DMPRO2021-Audio/pcb/readme.md

# PCB for synth project thingy

## [Bill of materials (google sheets)](https://docs.google.com/spreadsheets/d/1mw8S-eOHjplATXsi4Le0auCMZ8W1ZmBKjRO5l_0JOso/edit#gid=0)
