DMPRO2021-Audio/pcb/main/main.kicad_pcb

## KiCad design main/main.kicad_pcb (2021-09-30)

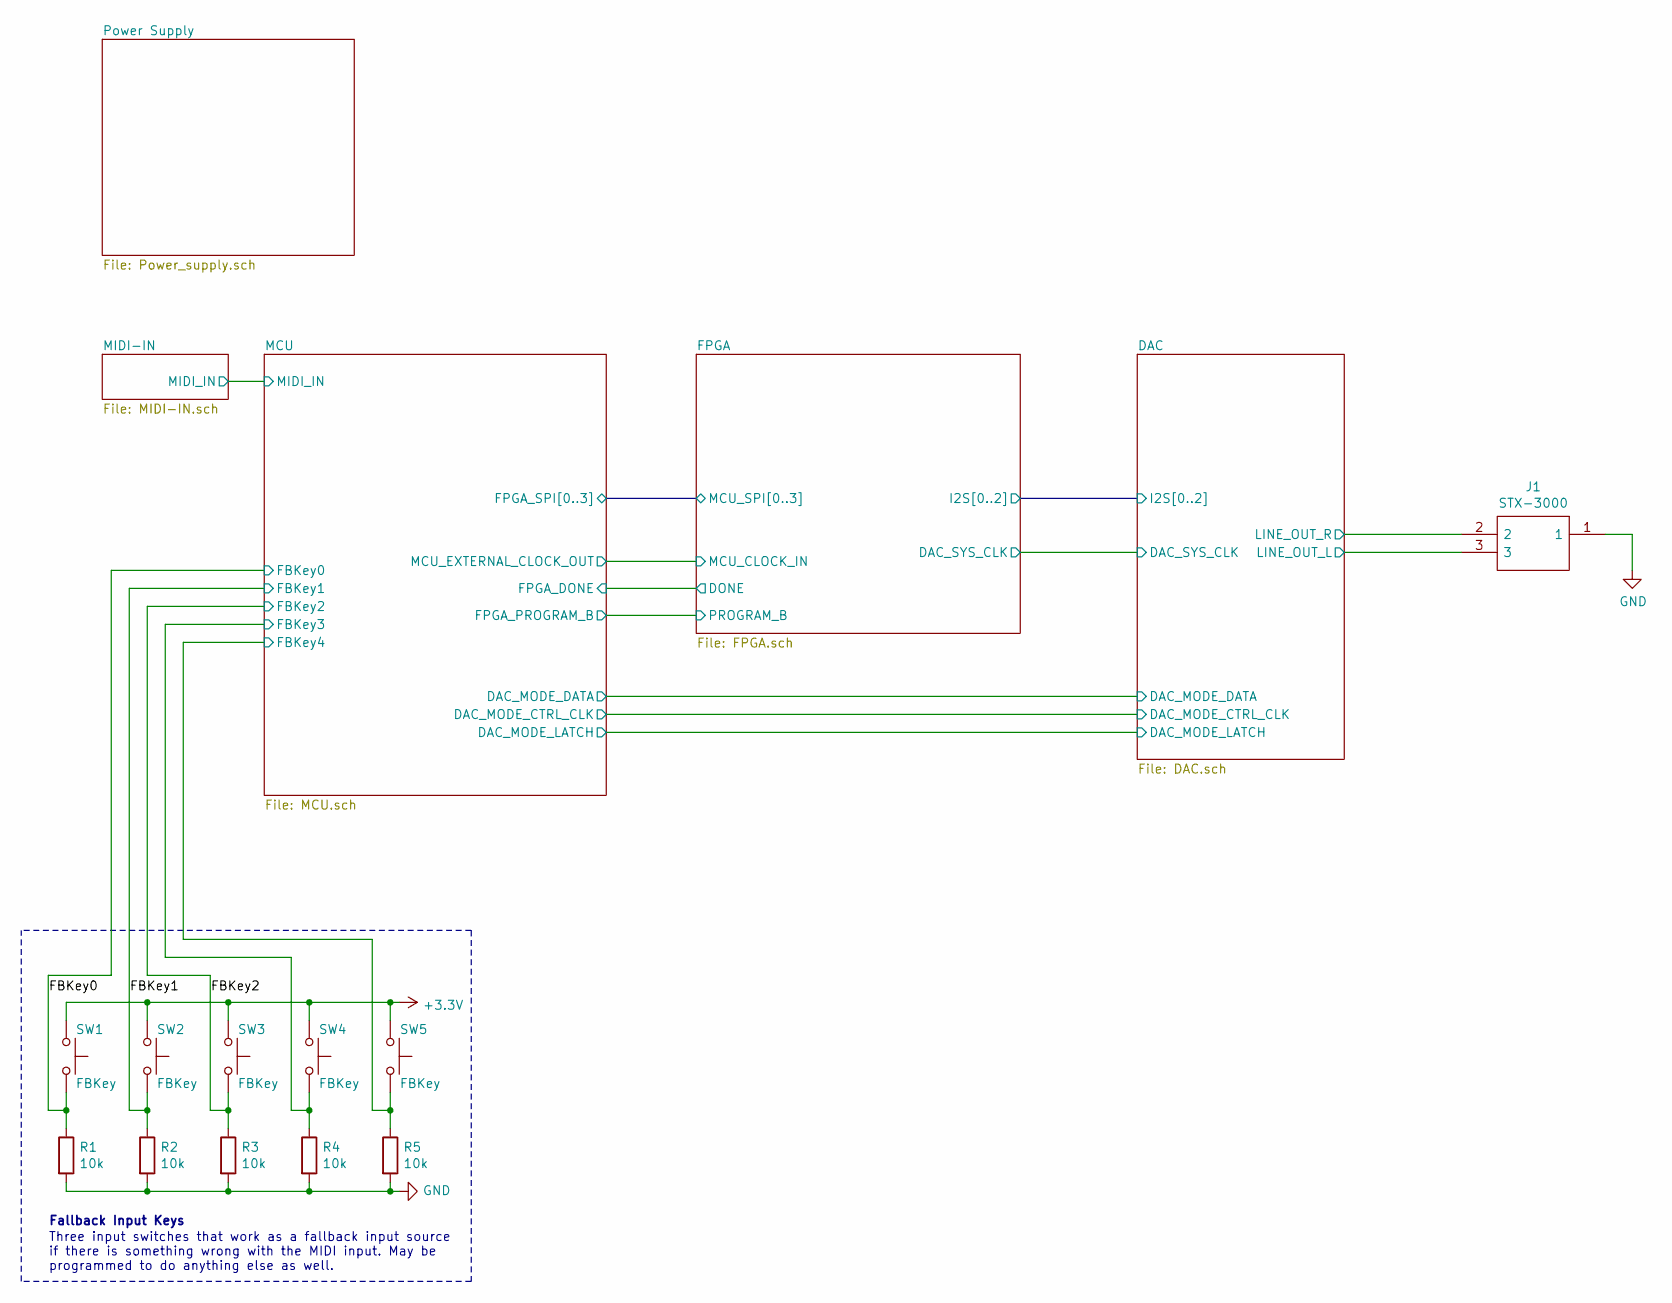
[picture p1: schematic main.sch, MIDI Audio Box]

Parts:
J1: STX-3000; STX3000; Manufacturer_Part_Number STX-3000
R1, R2, R3, R4, R5: 10k; R_0805_2012Metric_Pad1.20x1.40mm_HandSolder
SW1, SW2, SW3, SW4, SW5: FBKey; SW_Push_1P1T_NO_6x6mm_H9.5mm; Manufacturer_Part_Number PTS645SM43SMTR92 LFS

Connections:
+3V3: SW1.1, SW2.1, SW3.1, SW4.1, SW5.1; also elsewhere on the board
/DAC/LINE_OUT_L: J1.3; also elsewhere on the board
/DAC/LINE_OUT_R: J1.2; also elsewhere on the board
/FBKey0: R1.1, SW1.2; also elsewhere on the board
/FBKey1: R2.1, SW2.2; also elsewhere on the board
/FBKey2: R3.1, SW3.2; also elsewhere on the board
/MCU/FBKey3: R4.1, SW4.2; also elsewhere on the board
/MCU/FBKey4: R5.1, SW5.2; also elsewhere on the board
GND: J1.1, R1.2, R2.2, R3.2, R4.2, R5.2; also elsewhere on the board

Notes on the sheet:
Fallback Input Keys
Three input switches that work as a fallback input source if there is something wrong with the MIDI input. May be programmed to do anything else as well.

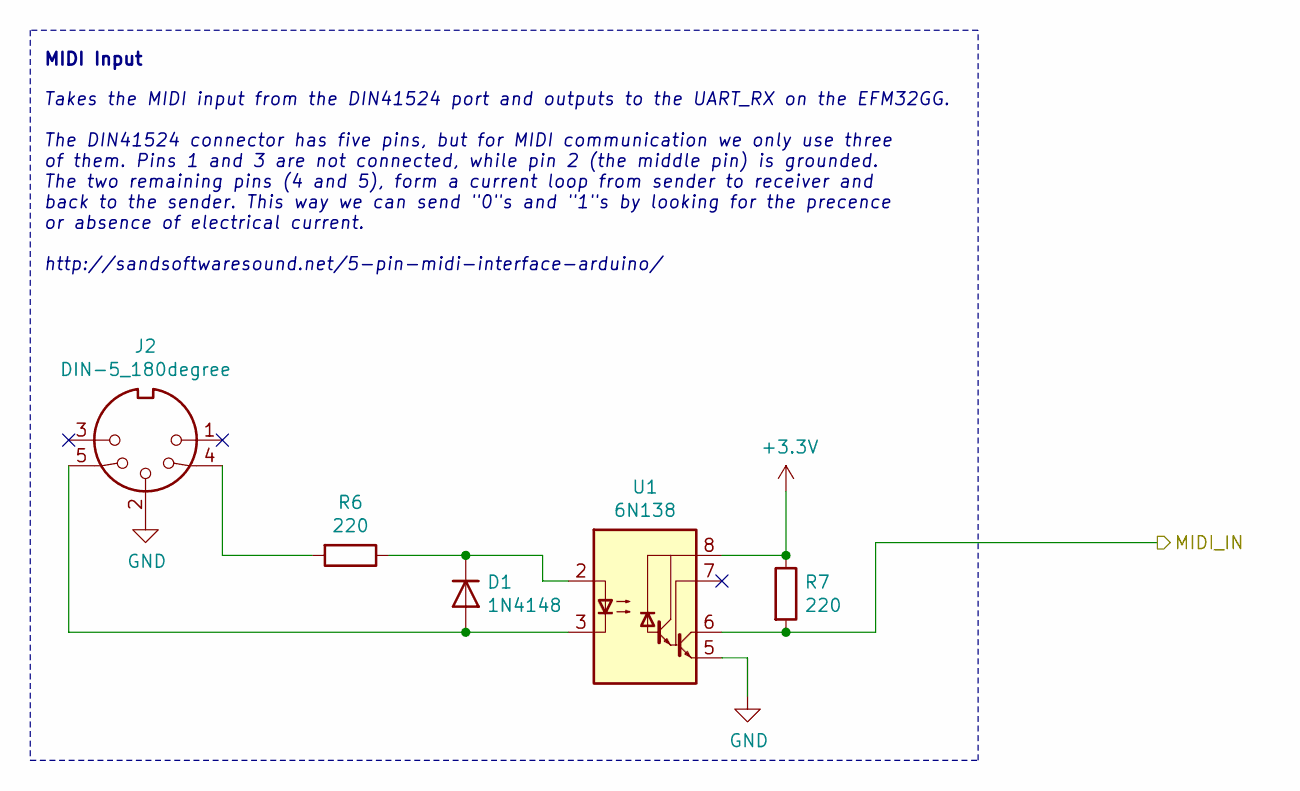
[picture p2: schematic MIDI-IN.sch, MIDI Audio Box]

Parts:
D1: 1N4148; D_SOD-123F; Manufacturer_Part_Number 1N4148W RH
J2: DIN-5_180degree; 671-0501; Manufacturer_Part_Number 671-0501
R6, R7: 220; R_0805_2012Metric_Pad1.20x1.40mm_HandSolder
U1: 6N138; SOP254P1030X460-8N; Manufacturer_Part_Number 6N138SMT/R

Connections:
+3V3: R7.1, U1.8 (VCC); also elsewhere on the board
/MCU/MIDI_IN: R7.2, U1.6 (VO2); also elsewhere on the board
GND: J2.2, U1.5 (GND); also elsewhere on the board
unnamed: D1.1 (K), R6.1, U1.2 (C1)
unnamed: D1.2 (A), J2.5, U1.3 (C2)
unnamed: J2.4, R6.2

Notes on the sheet:
MIDI Input
Takes the MIDI input from the DIN41524 port and outputs to the UART_RX on the EFM32GG. The DIN41524 connector has five pins, but for MIDI communication we only use three of them. Pins 1 and 3 are not connected, while pin 2 (the middle pin) is grounded. The two remaining pins (4 and 5), form a curre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

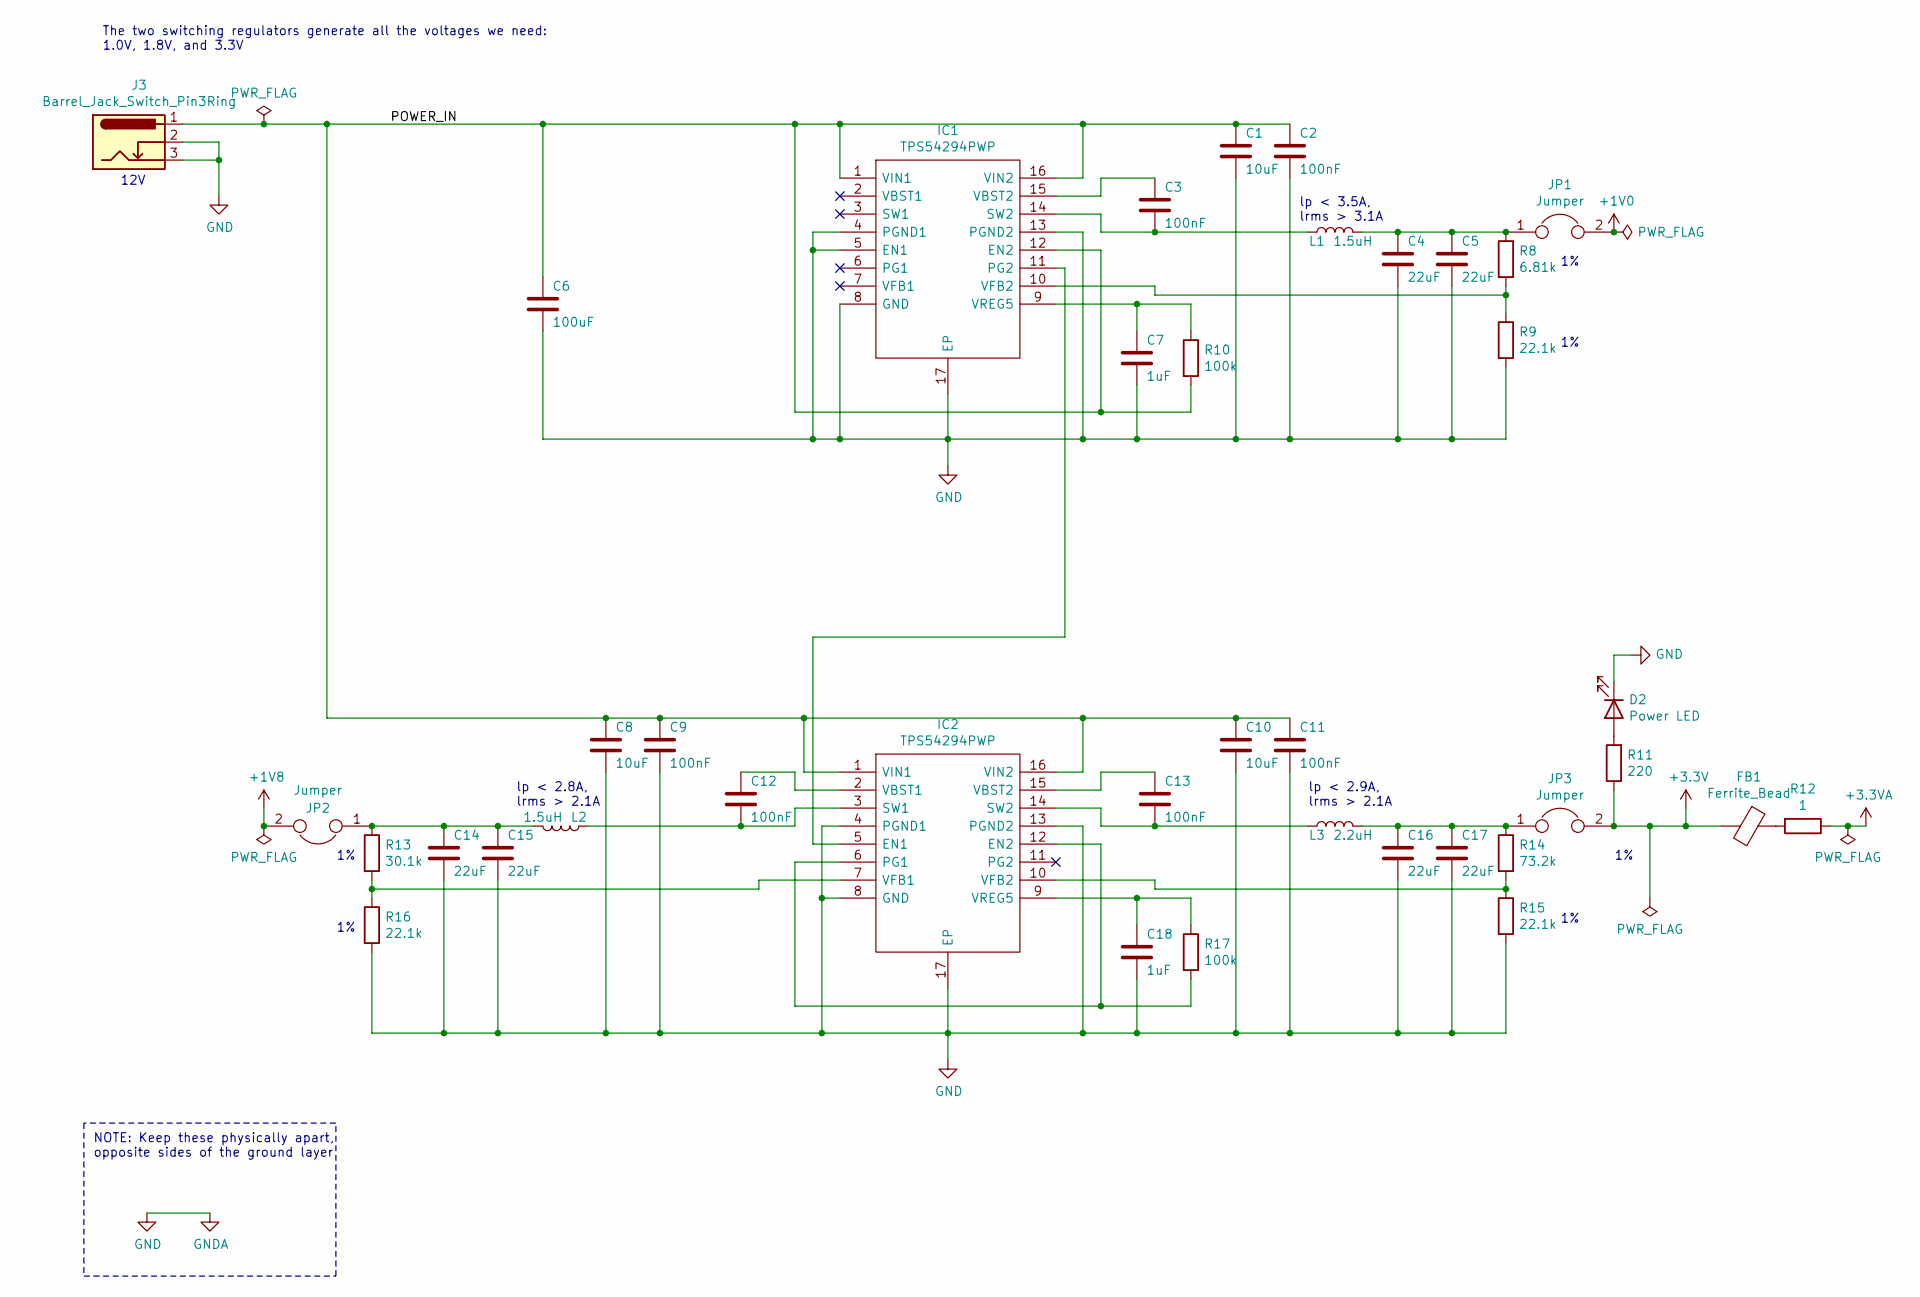
[picture p3: schematic Power_supply.sch, MIDI Audio Box]

Parts:
C1, C8, C10: 10uF; C_0805_2012Metric_Pad1.18x1.45mm_HandSolder
C2, C3, C9, C11, C12, C13: 100nF; C_0805_2012Metric_Pad1.18x1.45mm_HandSolder
C4, C5, C14, C15, C16, C17: 22uF; C_0805_2012Metric_Pad1.18x1.45mm_HandSolder
C6: 100uF; C_1210_3225Metric_Pad1.33x2.70mm_HandSolder
C7, C18: 1uF; C_0805_2012Metric_Pad1.18x1.45mm_HandSolder
D2: Power LED; LED_0805_2012Metric_Pad1.15x1.40mm_HandSolder; Manufacturer_Part_Number 150080RS75000
FB1: Ferrite_Bead; R_0805_2012Metric_Pad1.20x1.40mm_HandSolder; Manufacturer_Part_Number BMB2A0060LN2
IC1, IC2: TPS54294PWP; Manufacturer_Part_Number TPS54294PWP; Mouser Part Number 595-TPS54294PWP
J3: Barrel_Jack_Switch_Pin3Ring; BarrelJack_CUI_PJ-102AH_Horizontal; Manufacturer_Part_Number PJ-002A
JP1, JP2, JP3: Jumper; PinHeader_2x01_P2.54mm_Vertical
L1, L2: 1.5uH; L_1806_4516Metric_Pad1.57x1.80mm_HandSolder; Manufacturer_Part_Number 1286AS-H-2R2M=P2
L3: 2.2uH; L_1806_4516Metric_Pad1.57x1.80mm_HandSolder; Manufacturer_Part_Number DFE201610E-1R5M=P2
R8: 6.81k; R_0805_2012Metric_Pad1.20x1.40mm_HandSolder
R9, R15, R16: 22.1k; R_0805_2012Metric_Pad1.20x1.40mm_HandSolder
R10, R17: 100k; R_0805_2012Metric_Pad1.20x1.40mm_HandSolder
R11: 220; R_0805_2012Metric_Pad1.20x1.40mm_HandSolder
R12: 1; R_0805_2012Metric_Pad1.20x1.40mm_HandSolder
R13: 30.1k; R_0805_2012Metric_Pad1.20x1.40mm_HandSolder
R14: 73.2k; R_0805_2012Metric_Pad1.20x1.40mm_HandSolder

Connections:
+1V0: JP1.2; also elsewhere on the board
+1V8: JP2.2; also elsewhere on the board
+3.3VA: R12.1; also elsewhere on the board
+3V3: FB1.2, JP3.2, R11.1; also elsewhere on the board
/Power Supply/POWER_IN: C1.1, C2.1, C6.1, C8.1, C9.1, C10.1, C11.1, IC1.1 (VIN1), IC1.12 (EN2), IC1.16 (VIN2), IC2.1 (VIN1), IC2.16 (VIN2), J3.1, R10.2
GND: C1.2, C2.2, C4.2, C5.2, C6.2, C7.2, C8.2, C9.2, C10.2, C11.2, C14.2, C15.2, C16.2, C17.2, C18.2, D2.1 (K), IC1.4 (PGND1), IC1.5 (EN1), IC1.8 (GND), IC1.13 (PGND2), IC1.17 (EP), IC2.4 (PGND1), IC2.8 (GND), IC2.13 (PGND2), IC2.17 (EP), J3.2, J3.3, R9.2, R15.2, R16.2; also elsewhere on the board
unnamed: C3.1, IC1.15 (VBST2)
unnamed: C3.2, IC1.14 (SW2), L1.1
unnamed: C4.1, C5.1, JP1.1, L1.2, R8.1
unnamed: C7.1, IC1.9 (VREG5), R10.1
unnamed: C12.1, IC2.2 (VBST1)
unnamed: C12.2, IC2.3 (SW1), L2.1
unnamed: C13.1, IC2.15 (VBST2)
unnamed: C13.2, IC2.14 (SW2), L3.1
unnamed: C14.1, C15.1, JP2.1, L2.2, R13.1
unnamed: C16.1, C17.1, JP3.1, L3.2, R14.1
unnamed: C18.1, IC2.9 (VREG5), R17.1
unnamed: D2.2 (A), R11.2
unnamed: FB1.1, R12.2
unnamed: IC1.10 (VFB2), R8.2, R9.1
unnamed: IC1.11 (PG2), IC2.5 (EN1)
unnamed: IC2.7 (VFB1), R13.2, R16.1
unnamed: IC2.10 (VFB2), R14.2, R15.1
unnamed: IC2.6 (PG1), IC2.12 (EN2), R17.2

Notes on the sheet:
lp < 2.8A, lrms > 2.1A
lp < 2.9A, lrms > 2.1A
12V
lp < 3.5A, lrms > 3.1A
The two switching regulators generate all the voltages we need: 1.0V, 1.8V, and 3.3V
NOTE: Keep these physically apart, opposite sides of the ground layer

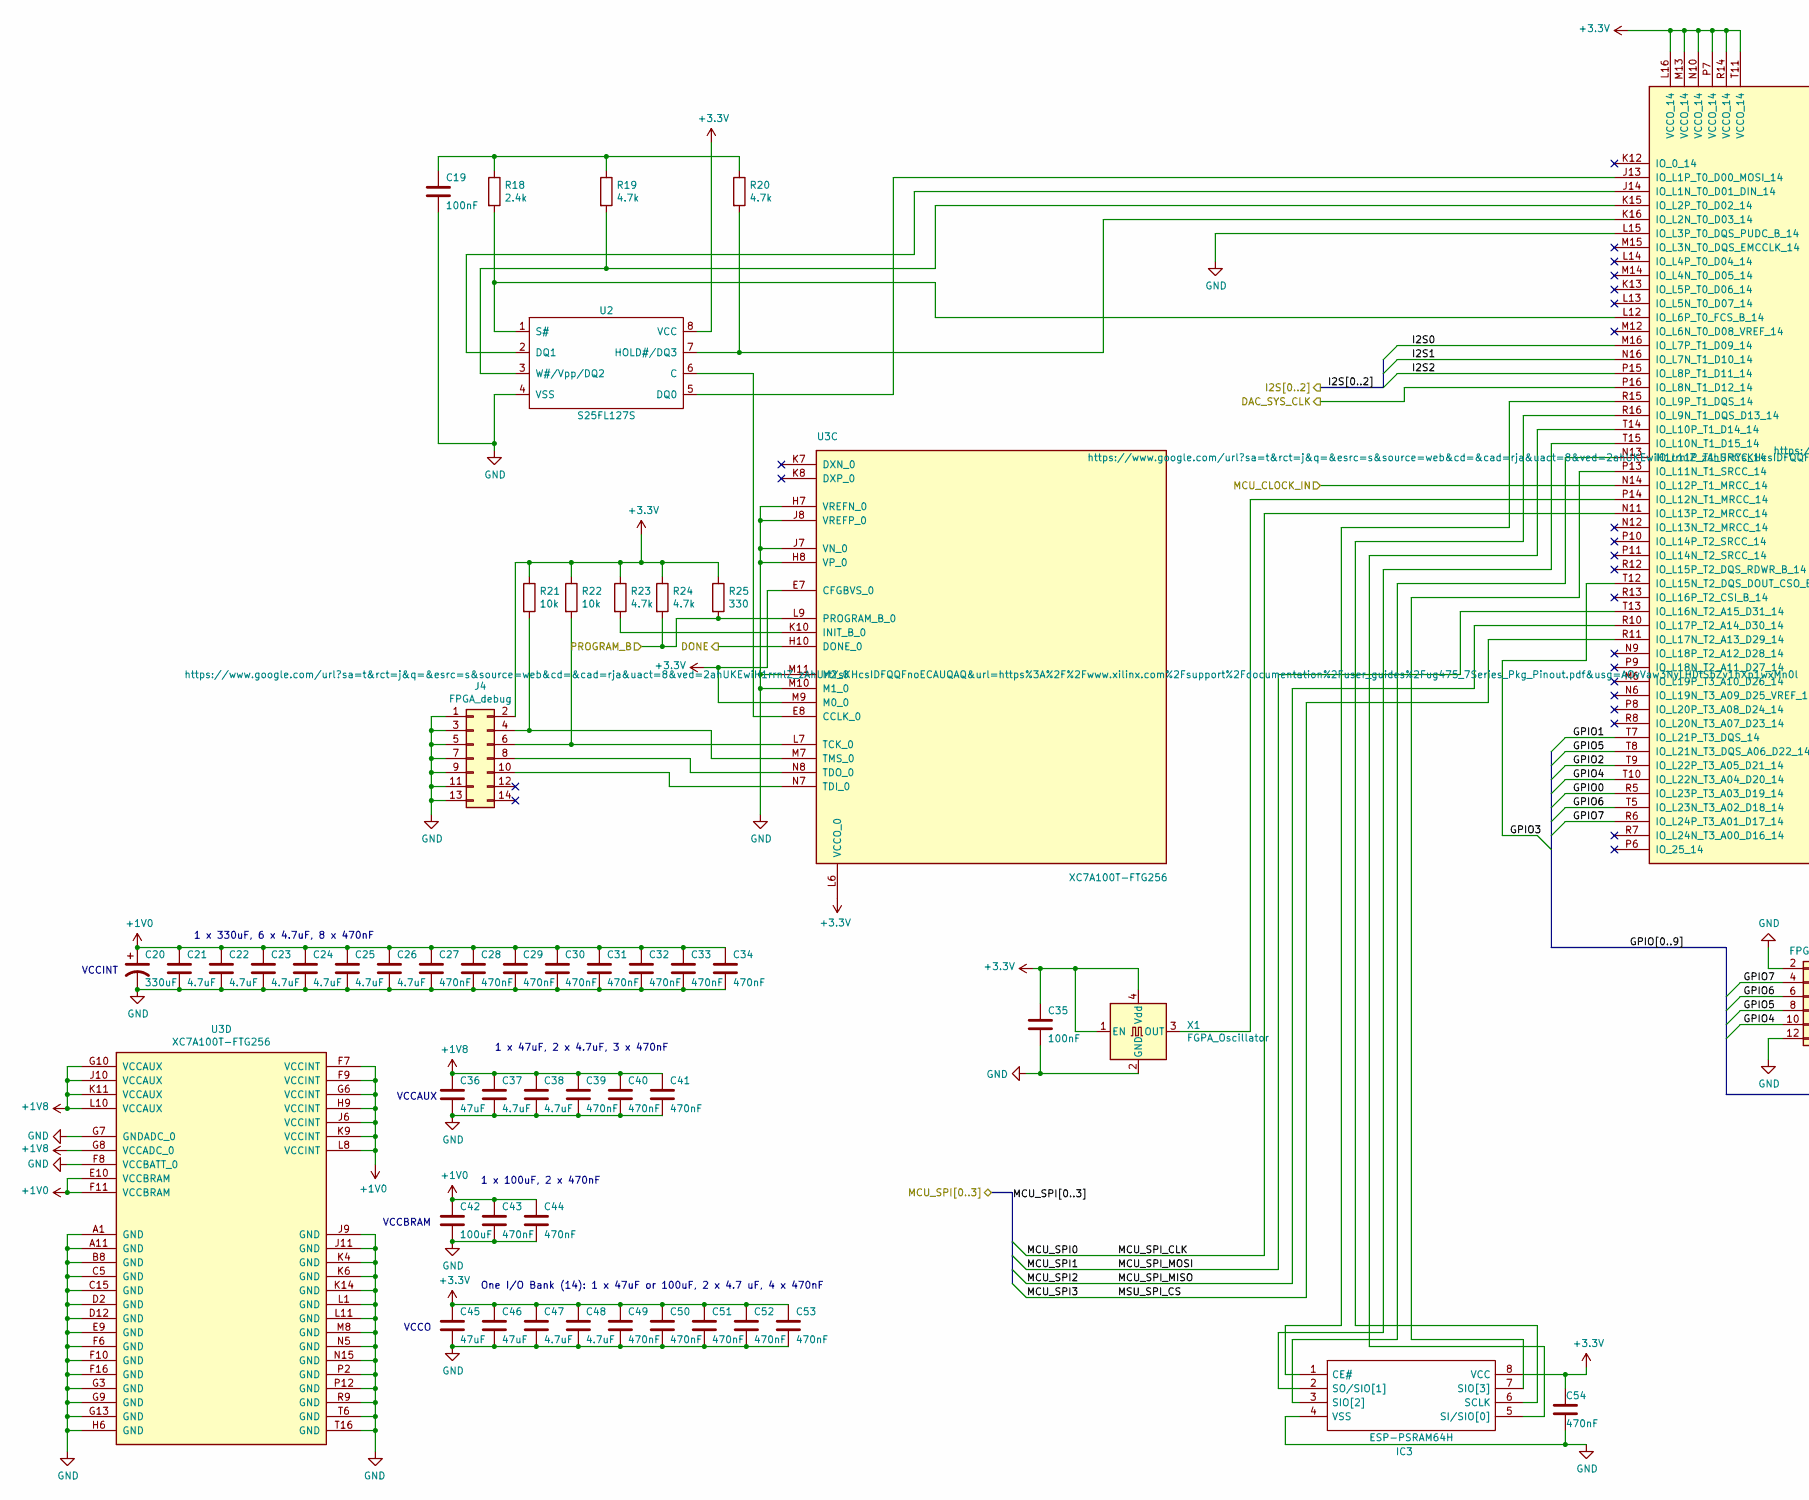
[picture p4: schematic FPGA.sch, MIDI Audio Box, part in row 1, column 1]

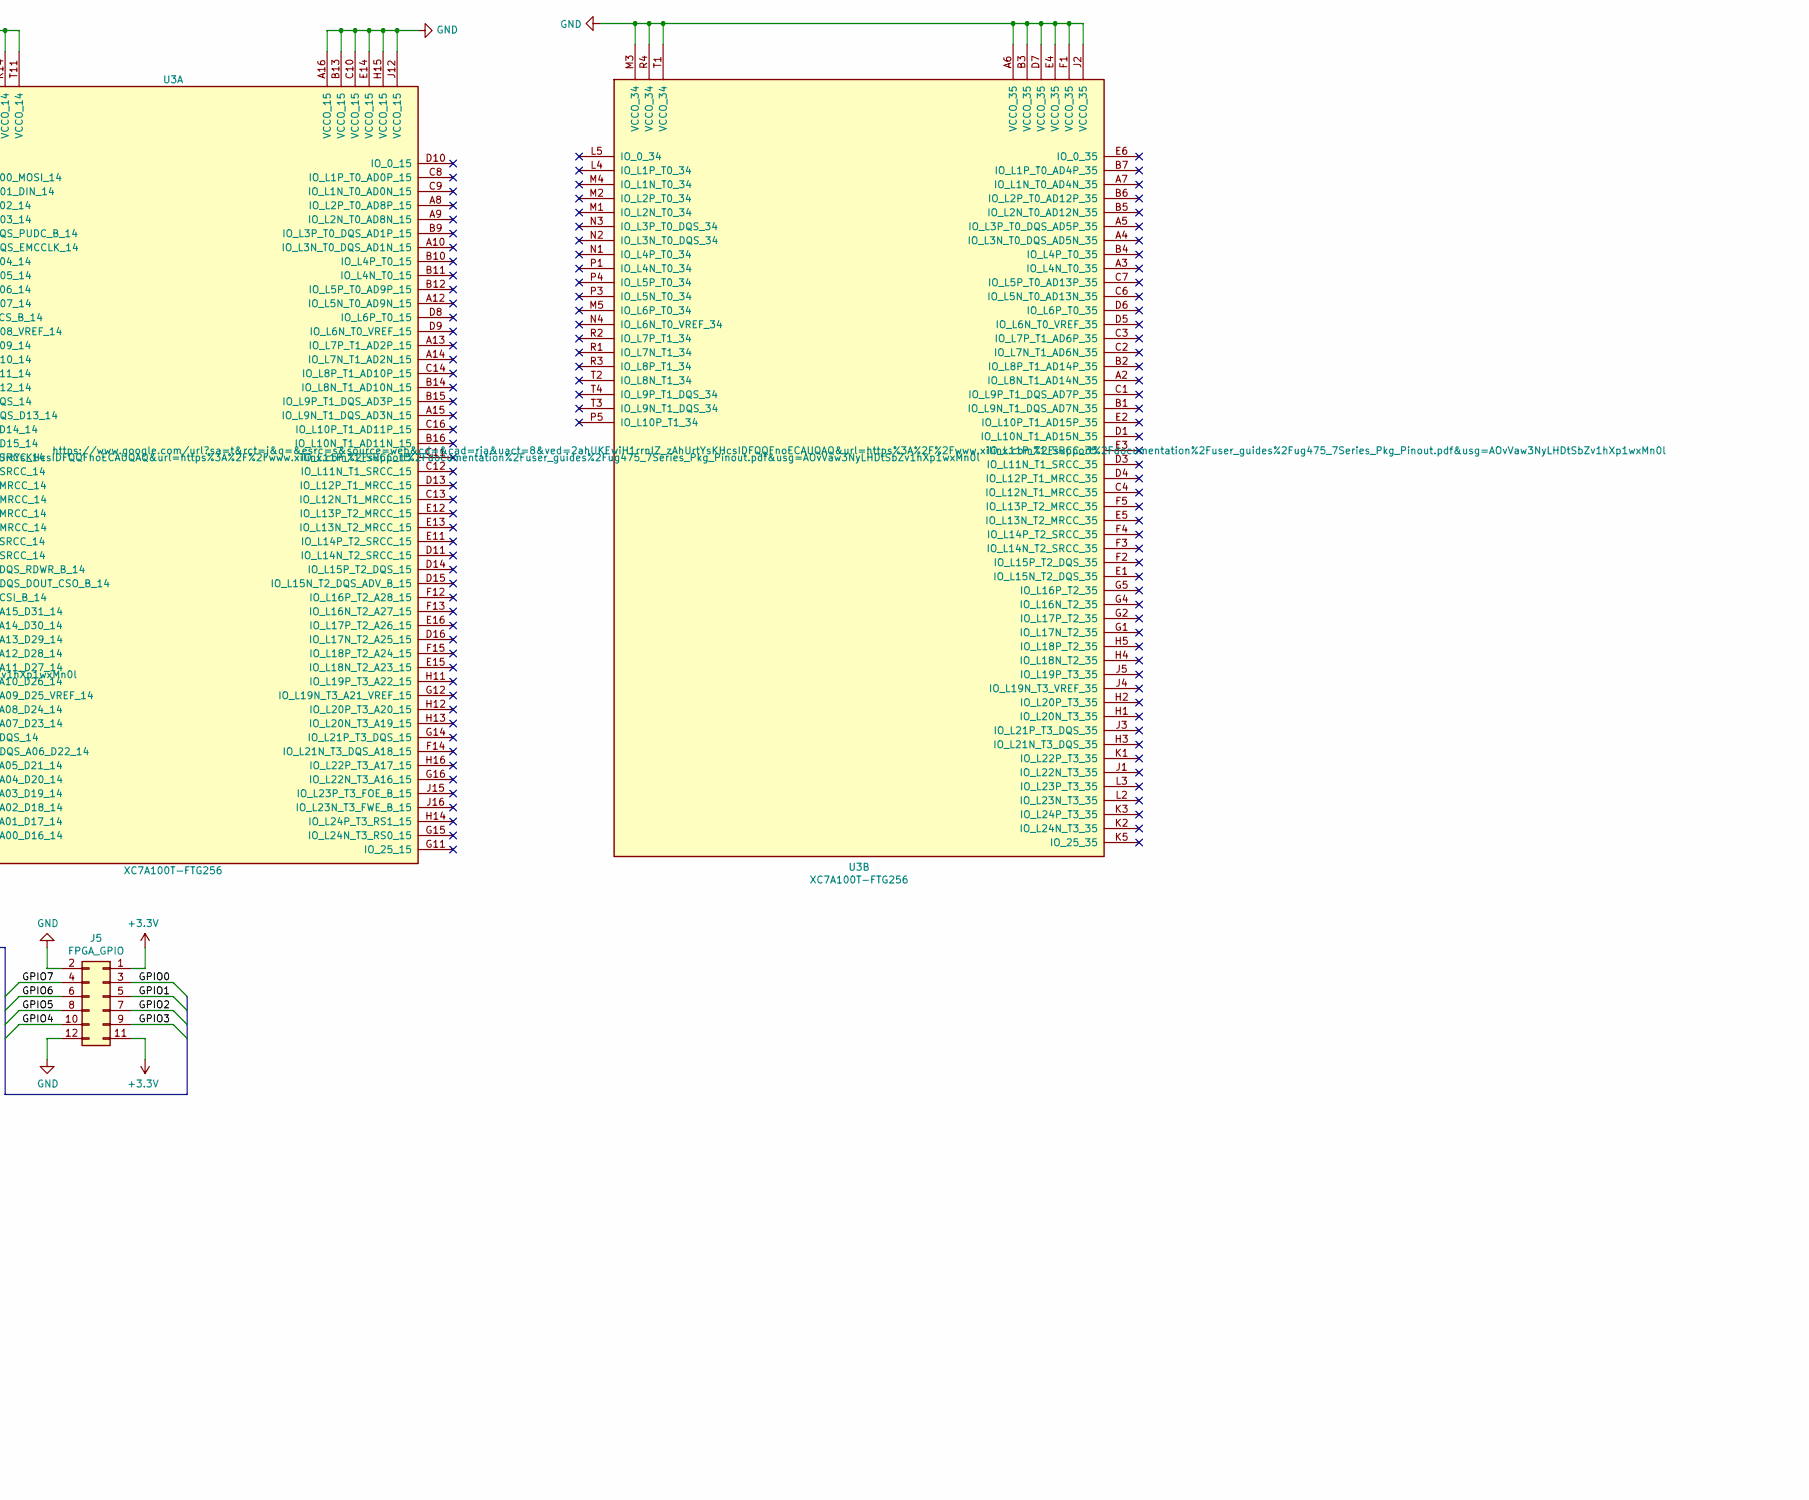
[picture p5: schematic FPGA.sch, MIDI Audio Box, part in row 1, column 2]

Parts:
C19, C35: 100nF; C_0805_2012Metric_Pad1.18x1.45mm_HandSolder
C20: 330uF; CP_EIA-7343-43_Kemet-X_Pad2.25x2.55mm_HandSolder
C21, C22, C23, C24, C25, C26, C37, C38, C47, C48: 4.7uF; C_0805_2012Metric_Pad1.18x1.45mm_HandSolder
C27, C28, C29, C30, C31, C32, C33, C34, C39, C40, C41, C43, C44, C49, C50, C51, C52, C53, C54: 470nF; C_0603_1608Metric_Pad1.08x0.95mm_HandSolder
C36, C45, C46: 47uF; C_1210_3225Metric_Pad1.33x2.70mm_HandSolder
C42: 100uF; C_1210_3225Metric_Pad1.33x2.70mm_HandSolder
IC3: ESP-PSRAM64H; SOIC127P600X175-8N; Manufacturer_Part_Number 4677
J4: FPGA_debug; PinHeader_2x07_P2.00mm_Vertical
J5: FPGA_GPIO; PinHeader_2x06_P2.54mm_Vertical; Manufacturer_Part_Number 2213S-50G
R18: 2.4k; R_0805_2012Metric_Pad1.20x1.40mm_HandSolder
R19, R20, R23, R24: 4.7k; R_0805_2012Metric_Pad1.20x1.40mm_HandSolder
R21, R22: 10k; R_0805_2012Metric_Pad1.20x1.40mm_HandSolder
R25: 330; R_0805_2012Metric_Pad1.20x1.40mm_HandSolder
U2: S25FL127S; SOIC-8_5.275x5.275mm_P1.27mm; Manufacturer_Part_Number S25FL127SABMFV101
U3: XC7A100T-FTG256; Xilinx_FTG256; Manufacturer_Part_Number XC7A100T-FTG256
X1: FGPA_Oscillator; Oscillator_SMD_SeikoEpson_SG210-4Pin_2.5x2.0mm_HandSoldering

Connections:
+1V0: C20.1, C21.1, C22.1, C23.1, C24.1, C25.1, C26.1, C27.1, C28.1, C29.1, C30.1, C31.1, C32.1, C33.1, C34.1, C42.1, C43.1, C44.1, U3.E10 (VCCBRAM), U3.F7 (VCCINT), U3.F9 (VCCINT), U3.F11 (VCCBRAM), U3.G6 (VCCINT), U3.H9 (VCCINT), U3.J6 (VCCINT), U3.K9 (VCCINT), U3.L8 (VCCINT); also elsewhere on the board
+1V8: C36.1, C37.1, C38.1, C39.1, C40.1, C41.1, U3.G8 (VCCADC_0), U3.G10 (VCCAUX), U3.J10 (VCCAUX), U3.K11 (VCCAUX), U3.L10 (VCCAUX); also elsewhere on the board
+3V3: C35.1, C45.1, C46.1, C47.1, C48.1, C49.1, C50.1, C51.1, C52.1, C53.1, C54.1, IC3.8 (VCC), J4.2, J5.1, J5.11, R21.1, R22.1, R23.1, R24.1, R25.1, U2.8 (VCC), U3.E7 (CFGBVS_0), U3.L6 (VCCO_0), U3.L16 (VCCO_14), U3.M9 (M0_0), U3.M13 (VCCO_14), U3.N10 (VCCO_14), U3.P7 (VCCO_14), U3.R14 (VCCO_14), U3.T11 (VCCO_14), X1.1 (EN), X1.4 (Vdd); also elsewhere on the board
/DAC/DAC_SYS_CLK: U3.P16 (IO_L8N_T1_D12_14); also elsewhere on the board
/DAC/I2S0: U3.M16 (IO_L7P_T1_D09_14); also elsewhere on the board
/DAC/I2S1: U3.N16 (IO_L7N_T1_D10_14); also elsewhere on the board
/DAC/I2S2: U3.P15 (IO_L8P_T1_D11_14); also elsewhere on the board
/FPGA/DONE: U3.H10 (DONE_0); also elsewhere on the board
/FPGA/GPIO0: J5.3, U3.R5 (IO_L23P_T3_A03_D19_14)
/FPGA/GPIO1: J5.5, U3.T7 (IO_L21P_T3_DQS_14)
/FPGA/GPIO2: J5.7, U3.T9 (IO_L22P_T3_A05_D21_14)
/FPGA/GPIO3: J5.9, U3.T12 (IO_L15N_T2_DQS_DOUT_CSO_B_14)
/FPGA/GPIO4: J5.10, U3.T10 (IO_L22N_T3_A04_D20_14)
/FPGA/GPIO5: J5.8, U3.T8 (IO_L21N_T3_DQS_A06_D22_14)
/FPGA/GPIO6: J5.6, U3.T5 (IO_L23N_T3_A02_D18_14)
/FPGA/GPIO7: J5.4, U3.R6 (IO_L24P_T3_A01_D17_14)
/FPGA/MCU_CLOCK_IN: U3.N14 (IO_L12P_T1_MRCC_14); also elsewhere on the board
/MCU/FPGA_PROGRAM_B: R24.2, R25.2, U3.L9 (PROGRAM_B_0); also elsewhere on the board
/MCU/FPGA_SPI0: U3.N11 (IO_L13P_T2_MRCC_14); also elsewhere on the board
/MCU/FPGA_SPI1: U3.T13 (IO_L16N_T2_A15_D31_14); also elsewhere on the board
/MCU/FPGA_SPI2: U3.R10 (IO_L17P_T2_A14_D30_14); also elsewhere on the board
/MCU/FPGA_SPI3: U3.R11 (IO_L17N_T2_A13_D29_14); also elsewhere on the board
GND: C19.2, C20.2, C21.2, C22.2, C23.2, C24.2, C25.2, C26.2, C27.2, C28.2, C29.2, C30.2, C31.2, C32.2, C33.2, C34.2, C35.2, C36.2, C37.2, C38.2, C39.2, C40.2, C41.2, C42.2, C43.2, C44.2, C45.2, C46.2, C47.2, C48.2, C49.2, C50.2, C51.2, C52.2, C53.2, C54.2, IC3.4 (VSS), J4.1, J4.3, J4.5, J4.7, J4.9, J4.11, J4.13, J5.2, J5.12, U2.4 (VSS), U3.A1 (GND), U3.A6 (VCCO_35), U3.A11 (GND), U3.A16 (VCCO_15), U3.B3 (VCCO_35), U3.B8 (GND), U3.B13 (VCCO_15), U3.C5 (GND), U3.C10 (VCCO_15), U3.C15 (GND), U3.D2 (GND), U3.D7 (VCCO_35), U3.D12 (GND), U3.E4 (VCCO_35), U3.E9 (GND), U3.E14 (VCCO_15), U3.F1 (VCCO_35), U3.F6 (GND), U3.F8 (VCCBATT_0), U3.F10 (GND), U3.F16 (GND), U3.G3 (GND), U3.G7 (GNDADC_0), U3.G9 (GND), U3.G13 (GND), U3.H6 (GND), U3.H7 (VREFN_0), U3.H8 (VP_0), U3.H15 (VCCO_15), U3.J2 (VCCO_35), U3.J7 (VN_0), U3.J8 (VREFP_0), U3.J9 (GND), U3.J11 (GND), U3.J12 (VCCO_15), U3.K4 (GND), U3.K6 (GND), U3.K14 (GND), U3.L1 (GND), U3.L11 (GND), U3.L15 (IO_L3P_T0_DQS_PUDC_B_14), U3.M3 (VCCO_34), U3.M8 (GND), U3.M10 (M1_0), U3.M11 (M2_0), U3.N5 (GND), U3.N15 (GND), U3.P2 (GND), U3.P12 (GND), U3.R4 (VCCO_34), U3.R9 (GND), U3.T1 (VCCO_34), U3.T6 (GND), U3.T16 (GND), X1.2 (GND); also elsewhere on the board
unnamed: C19.1, R18.1, R19.1, R20.1
unnamed: IC3.1 (CE#), U3.R15 (IO_L9P_T1_DQS_14)
unnamed: IC3.2 (SO/SIO[1]), U3.T15 (IO_L10N_T1_D15_14)
unnamed: IC3.3 (SIO[2]), U3.N13 (IO_L11P_T1_SRCC_14)
unnamed: IC3.5 (SI/SIO[0]), U3.T14 (IO_L10P_T1_D14_14)
unnamed: IC3.6 (SCLK), U3.R16 (IO_L9N_T1_DQS_D13_14)
unnamed: IC3.7 (SIO[3]), U3.P13 (IO_L11N_T1_SRCC_14)
unnamed: J4.4, R21.2, U3.M7 (TMS_0)
unnamed: J4.6, R22.2, U3.L7 (TCK_0)
unnamed: J4.8, U3.N8 (TDO_0)
unnamed: J4.10, U3.N7 (TDI_0)
unnamed: R18.2, U2.1 (S#), U3.L12 (IO_L6P_T0_FCS_B_14)
unnamed: R19.2, U2.3 (W#/Vpp/DQ2), U3.K15 (IO_L2P_T0_D02_14)
unnamed: R20.2, U2.7 (HOLD#/DQ3), U3.K16 (IO_L2N_T0_D03_14)
unnamed: R23.2, U3.K10 (INIT_B_0)
unnamed: U2.2 (DQ1), U3.J14 (IO_L1N_T0_D01_DIN_14)
unnamed: U2.5 (DQ0), U3.J13 (IO_L1P_T0_D00_MOSI_14)
unnamed: U2.6 (C), U3.E8 (CCLK_0)
unnamed: U3.P14 (IO_L12N_T1_MRCC_14), X1.3 (OUT)

Notes on the sheet:
VCCINT
VCCBRAM
VCCAUX
VCCO
1 x 330uF, 6 x 4.7uF, 8 x 470nF
1 x 47uF, 2 x 4.7uF, 3 x 470nF
1 x 100uF, 2 x 470nF
One I/O Bank (14): 1 x 47uF or 100uF, 2 x 4.7 uF, 4 x 470nF

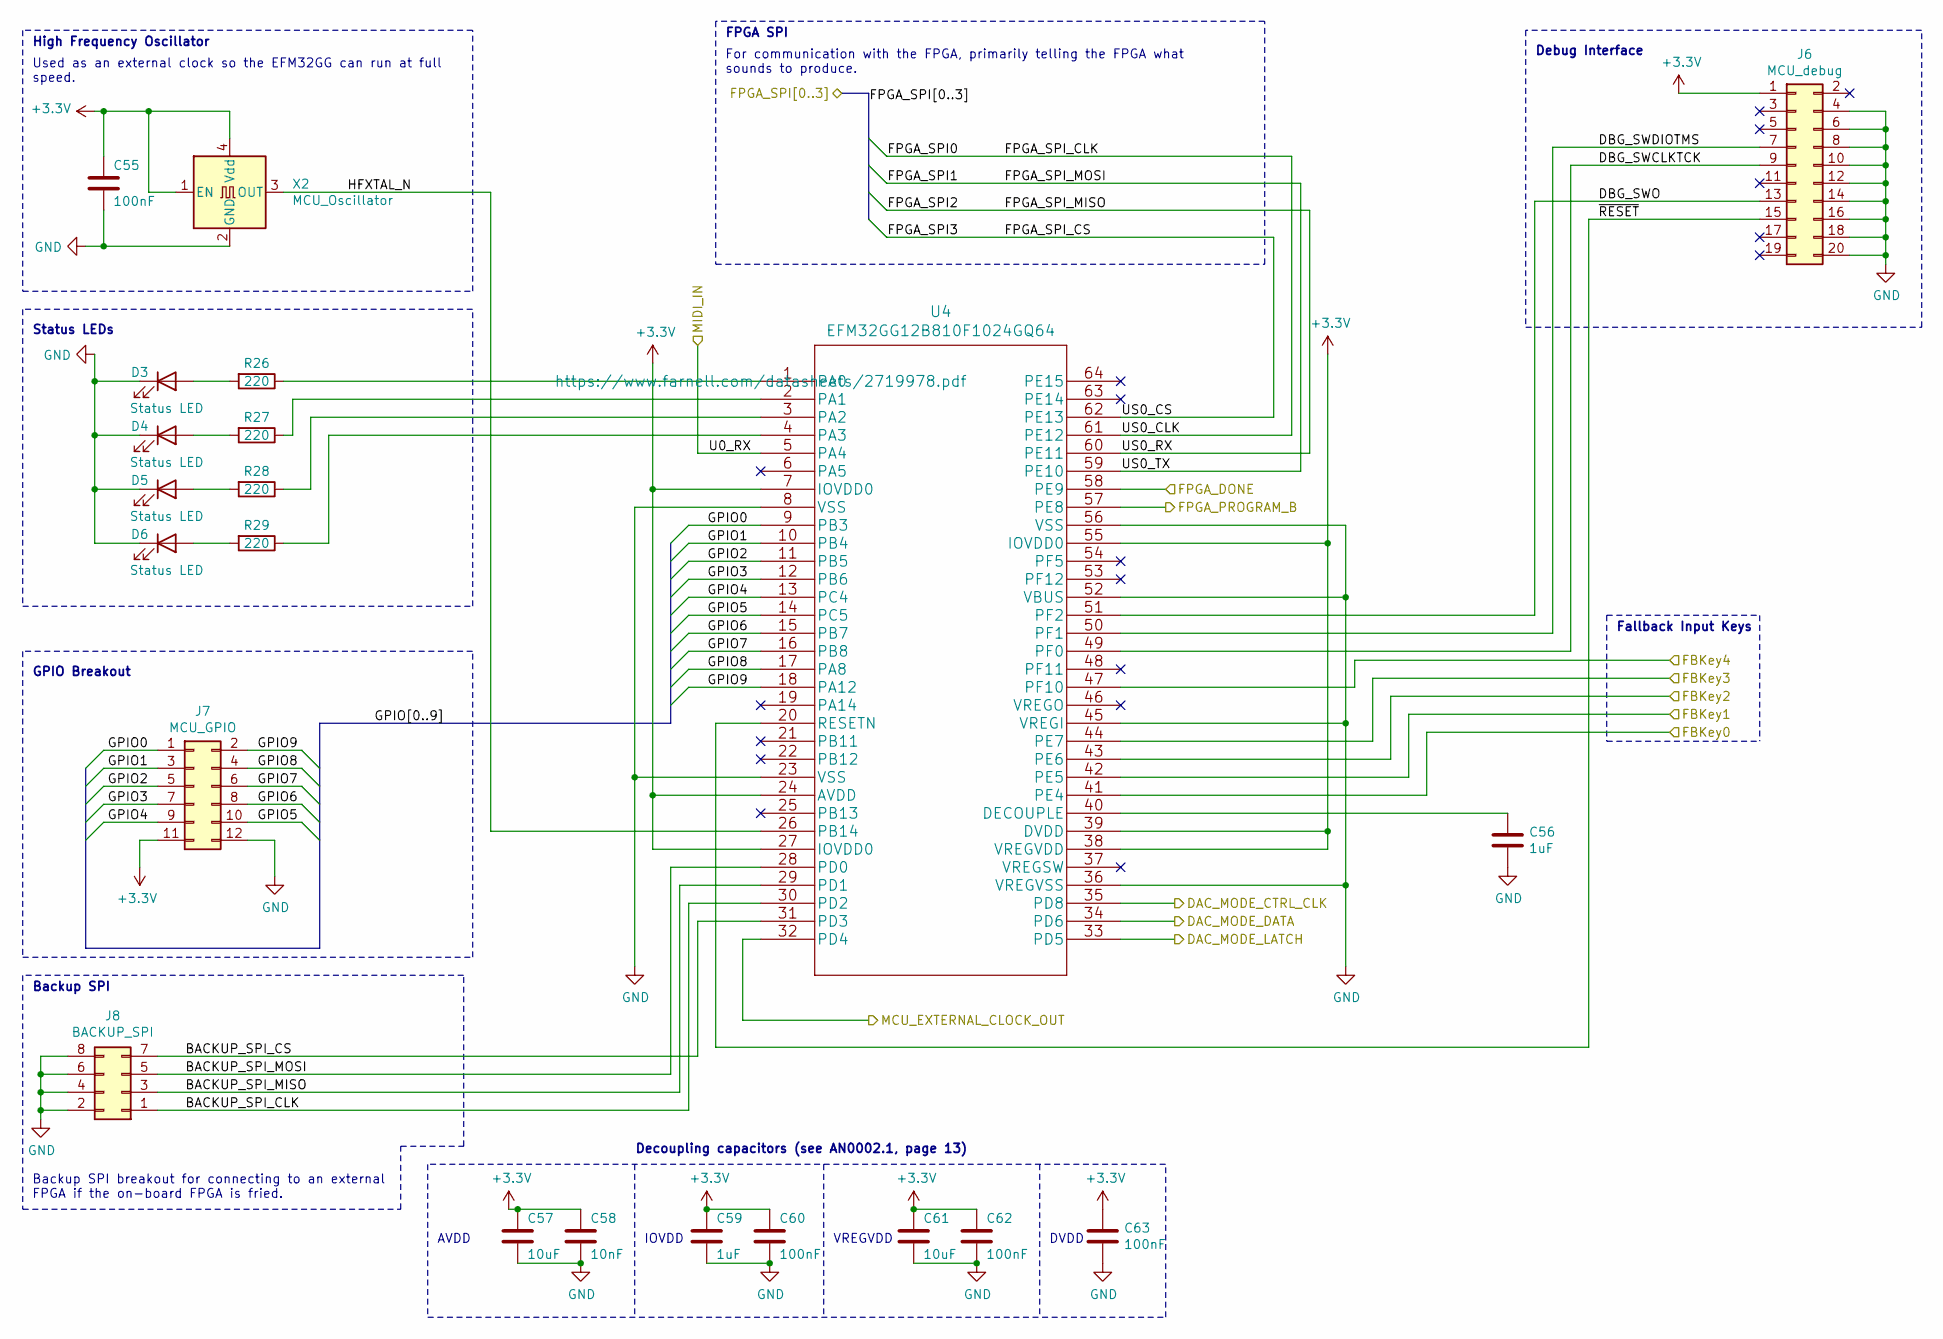
[picture p6: schematic MCU.sch, MIDI Audio Box]

Parts:
C55, C60, C62, C63: 100nF; C_0805_2012Metric_Pad1.18x1.45mm_HandSolder
C56, C59: 1uF; C_0805_2012Metric_Pad1.18x1.45mm_HandSolder
C57, C61: 10uF; C_0805_2012Metric_Pad1.18x1.45mm_HandSolder
C58: 10nF; C_0805_2012Metric_Pad1.18x1.45mm_HandSolder
D3, D4, D5, D6: Status LED; LED_0805_2012Metric_Pad1.15x1.40mm_HandSolder; Manufacturer_Part_Number 150080RS75000
J6: MCU_debug; PinHeader_2x10_P1.27mm_Vertical
J7: MCU_GPIO; PinHeader_2x06_P2.54mm_Vertical
J8: BACKUP_SPI; PinHeader_2x04_P2.54mm_Vertical
R26, R27, R28, R29: 220; R_0805_2012Metric_Pad1.20x1.40mm_HandSolder
U4: EFM32GG12B810F1024GQ64; Manufacturer_Part_Number EFM32GG12B810F1024GQ64-A
X2: MCU_Oscillator; Oscillator_SMD_SeikoEpson_SG210-4Pin_2.5x2.0mm_HandSoldering

Connections:
+3V3: C55.1, C57.1, C58.1, C59.1, C60.1, C61.1, C62.1, C63.1, J6.1, J7.11, U4.7 (IOVDD0), U4.24 (AVDD), U4.27 (IOVDD0), U4.38 (VREGVDD), U4.39 (DVDD), U4.55 (IOVDD0), X2.1 (EN), X2.4 (Vdd); also elsewhere on the board
/DAC/DAC_MODE_CTRL_CLK: U4.35 (PD8); also elsewhere on the board
/DAC/DAC_MODE_DATA: U4.34 (PD6); also elsewhere on the board
/DAC/DAC_MODE_LATCH: U4.33 (PD5); also elsewhere on the board
/FBKey0: U4.41 (PE4); also elsewhere on the board
/FBKey1: U4.42 (PE5); also elsewhere on the board
/FBKey2: U4.43 (PE6); also elsewhere on the board
/FPGA/DONE: U4.58 (PE9); also elsewhere on the board
/FPGA/MCU_CLOCK_IN: U4.32 (PD4); also elsewhere on the board
/MCU/BACKUP_SPI_CLK: J8.1, U4.30 (PD2)
/MCU/BACKUP_SPI_CS: J8.7, U4.31 (PD3)
/MCU/BACKUP_SPI_MISO: J8.3, U4.29 (PD1)
/MCU/BACKUP_SPI_MOSI: J8.5, U4.28 (PD0)
/MCU/DBG_SWCLKTCK: J6.9, U4.49 (PF0)
/MCU/DBG_SWDIOTMS: J6.7, U4.50 (PF1)
/MCU/DBG_SWO: J6.13, U4.51 (PF2)
/MCU/FBKey3: U4.44 (PE7); also elsewhere on the board
/MCU/FBKey4: U4.47 (PF10); also elsewhere on the board
/MCU/FPGA_PROGRAM_B: U4.57 (PE8); also elsewhere on the board
/MCU/FPGA_SPI0: U4.61 (PE12); also elsewhere on the board
/MCU/FPGA_SPI1: U4.59 (PE10); also elsewhere on the board
/MCU/FPGA_SPI2: U4.60 (PE11); also elsewhere on the board
/MCU/FPGA_SPI3: U4.62 (PE13); also elsewhere on the board
/MCU/GPIO0: J7.1, U4.9 (PB3)
/MCU/GPIO1: J7.3, U4.10 (PB4)
/MCU/GPIO2: J7.5, U4.11 (PB5)
/MCU/GPIO3: J7.7, U4.12 (PB6)
/MCU/GPIO4: J7.9, U4.13 (PC4)
/MCU/GPIO5: J7.10, U4.14 (PC5)
/MCU/GPIO6: J7.8, U4.15 (PB7)
/MCU/GPIO7: J7.6, U4.16 (PB8)
/MCU/GPIO8: J7.4, U4.17 (PA8)
/MCU/GPIO9: J7.2, U4.18 (PA12)
/MCU/HFXTAL_N: U4.26 (PB14), X2.3 (OUT)
/MCU/MIDI_IN: U4.5 (PA4); also elsewhere on the board
/MCU/~RESET: J6.15, U4.20 (RESETN)
GND: C55.2, C56.2, C57.2, C58.2, C59.2, C60.2, C61.2, C62.2, C63.2, D3.1 (K), D4.1 (K), D5.1 (K), D6.1 (K), J6.4, J6.6, J6.8, J6.10, J6.12, J6.14, J6.16, J6.18, J6.20, J7.12, J8.2, J8.4, J8.6, J8.8, U4.8 (VSS), U4.23 (VSS), U4.36 (VREGVSS), U4.45 (VREGI), U4.52 (VBUS), U4.56 (VSS), X2.2 (GND); also elsewhere on the board
unnamed: C56.1, U4.40 (DECOUPLE)
unnamed: D3.2 (A), R26.2
unnamed: D4.2 (A), R27.2
unnamed: D5.2 (A), R28.2
unnamed: D6.2 (A), R29.2
unnamed: R26.1, U4.1 (PA0)
unnamed: R27.1, U4.2 (PA1)
unnamed: R28.1, U4.3 (PA2)
unnamed: R29.1, U4.4 (PA3)

Notes on the sheet:
VREGVDD
AVDD
IOVDD
DVDD
Backup SPI breakout for connecting to an external FPGA if the on-board FPGA is fried.
Status LEDs
GPIO Breakout
Debug Interface
Fallback Input Keys
FPGA SPI
For communication with the FPGA, primarily telling the FPGA what sounds to produce.
Backup SPI
Decoupling capacitors (see AN0002.1, page 13)
Used as an external clock so the EFM32GG can run at full speed.
High Frequency Oscillator
