DMPRO2021-Audio/pcb/main/main.kicad_pcb

## KiCad design main/main.kicad_pcb (continued)

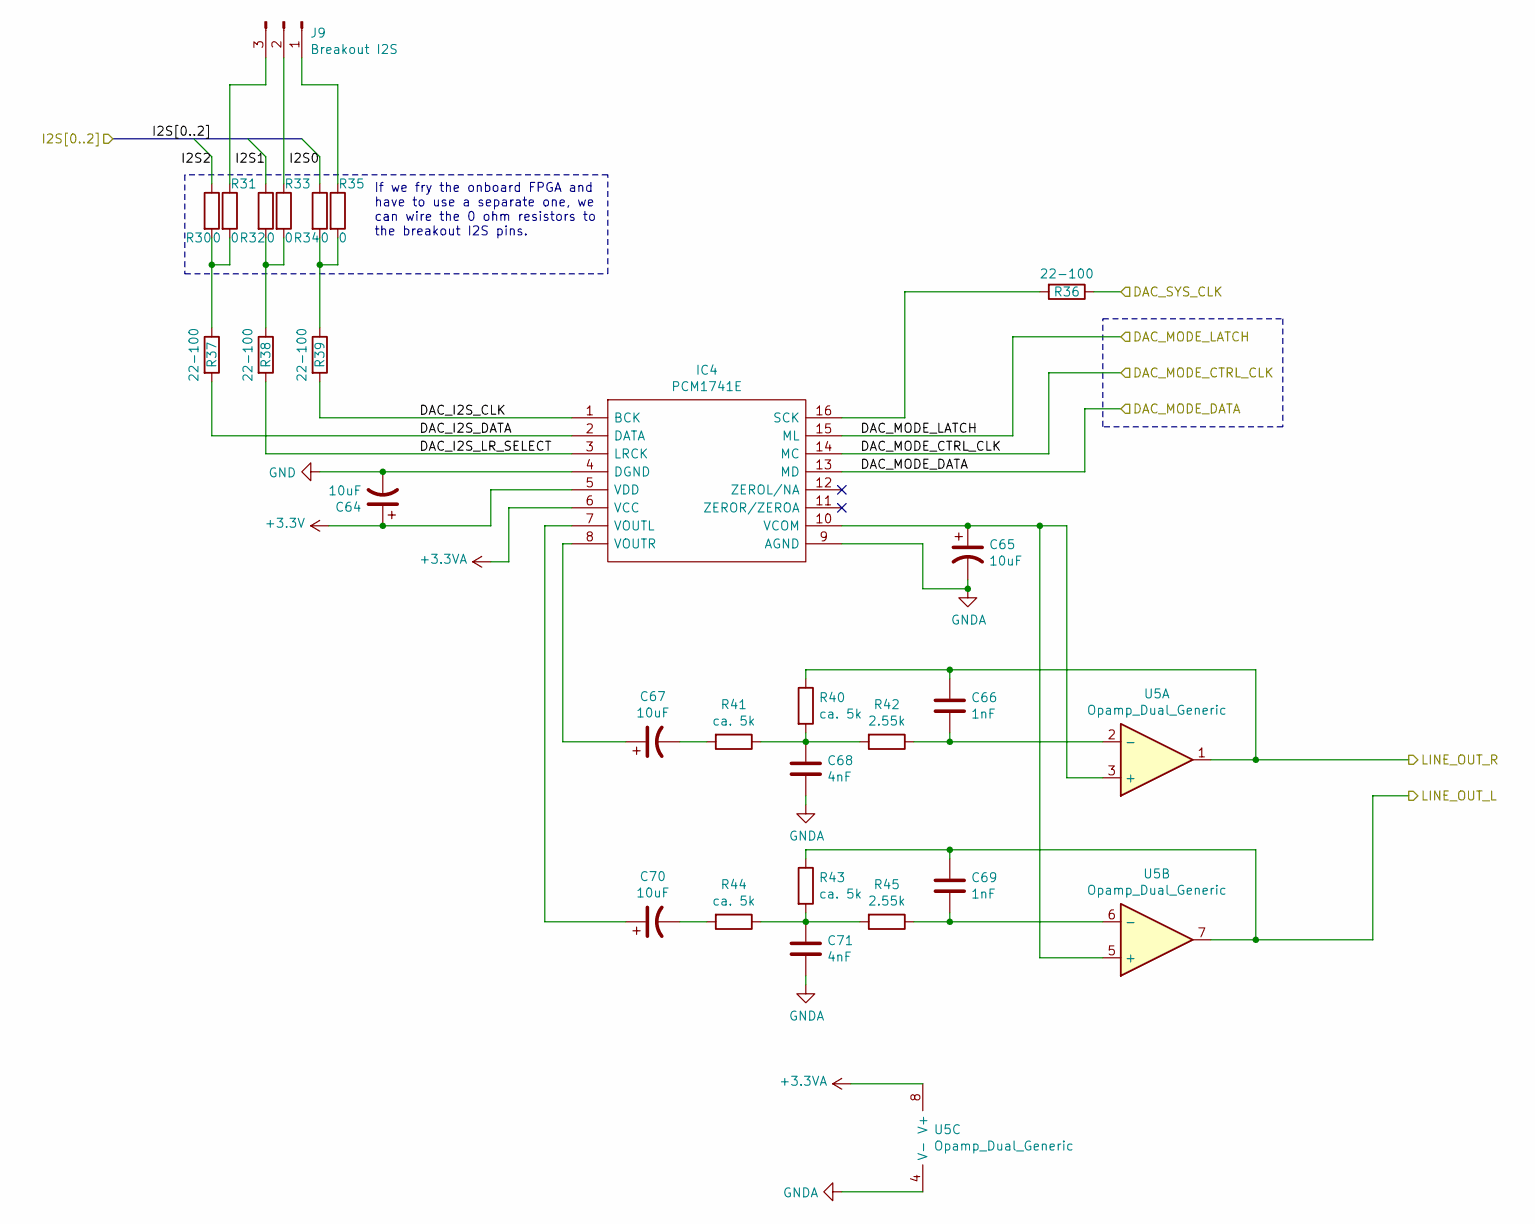
[picture p7: schematic DAC.sch, MIDI Audio Box]

Parts:
C64, C65, C67, C70: 10uF; CP_EIA-3528-12_Kemet-T_Pad1.50x2.35mm_HandSolder
C66, C69: 1nF; C_0805_2012Metric_Pad1.18x1.45mm_HandSolder
C68, C71: 4nF; C_0805_2012Metric_Pad1.18x1.45mm_HandSolder
IC4: PCM1741E; SOP63P600X175-16N; Manufacturer_Part_Number PCM1741E; Mouser Part Number 595-PCM1741E
J9: Breakout I2S; PinHeader_1x03_P2.54mm_Vertical
R30, R32, R34: 0; SolderJumper-2_P1.3mm_Bridged2Bar_RoundedPad1.0x1.5mm
R31, R33, R35: 0; SolderJumper-2_P1.3mm_Open_RoundedPad1.0x1.5mm
R36, R37, R38, R39: 22-100; R_0805_2012Metric_Pad1.20x1.40mm_HandSolder
R40, R41, R43, R44: ca. 5k; R_0805_2012Metric_Pad1.20x1.40mm_HandSolder
R42, R45: 2.55k; R_0805_2012Metric_Pad1.20x1.40mm_HandSolder
U5: Opamp_Dual_Generic; SOIC-8_5.23x5.23mm_P1.27mm; Manufacturer_Part_Number OPA2353UA

Connections:
+3.3VA: IC4.6 (VCC), U5.8 (V+); also elsewhere on the board
+3V3: C64.1, IC4.5 (VDD); also elsewhere on the board
/DAC/DAC_I2S_CLK: IC4.1 (BCK), R39.2
/DAC/DAC_I2S_DATA: IC4.2 (DATA), R37.2
/DAC/DAC_I2S_LR_SELECT: IC4.3 (LRCK), R38.2
/DAC/DAC_MODE_CTRL_CLK: IC4.14 (MC); also elsewhere on the board
/DAC/DAC_MODE_DATA: IC4.13 (MD); also elsewhere on the board
/DAC/DAC_MODE_LATCH: IC4.15 (ML); also elsewhere on the board
/DAC/DAC_SYS_CLK: R36.1; also elsewhere on the board
/DAC/I2S0: R34.1; also elsewhere on the board
/DAC/I2S1: R32.1; also elsewhere on the board
/DAC/I2S2: R30.1; also elsewhere on the board
/DAC/LINE_OUT_L: C69.1, R43.1, U5.7; also elsewhere on the board
/DAC/LINE_OUT_R: C66.1, R40.1, U5.1; also elsewhere on the board
GND: C64.2, C65.2, C68.2, C71.2, IC4.4 (DGND), IC4.9 (AGND), U5.4 (V-); also elsewhere on the board
unnamed: C65.1, IC4.10 (VCOM), U5.3 (+), U5.5 (+)
unnamed: C66.2, R42.1, U5.2 (-)
unnamed: C67.1, IC4.8 (VOUTR)
unnamed: C67.2, R41.2
unnamed: C68.1, R40.2, R41.1, R42.2
unnamed: C69.2, R45.1, U5.6 (-)
unnamed: C70.1, IC4.7 (VOUTL)
unnamed: C70.2, R44.2
unnamed: C71.1, R43.2, R44.1, R45.2
unnamed: IC4.16 (SCK), R36.2
unnamed: J9.1, R35.1
unnamed: J9.2, R33.1
unnamed: J9.3, R31.1
unnamed: R30.2, R31.2, R37.1
unnamed: R32.2, R33.2, R38.1
unnamed: R34.2, R35.2, R39.1

Notes on the sheet:
If we fry the onboard FPGA and have to use a separate one, we can wire the 0 ohm resistors to the breakout I2S pins.

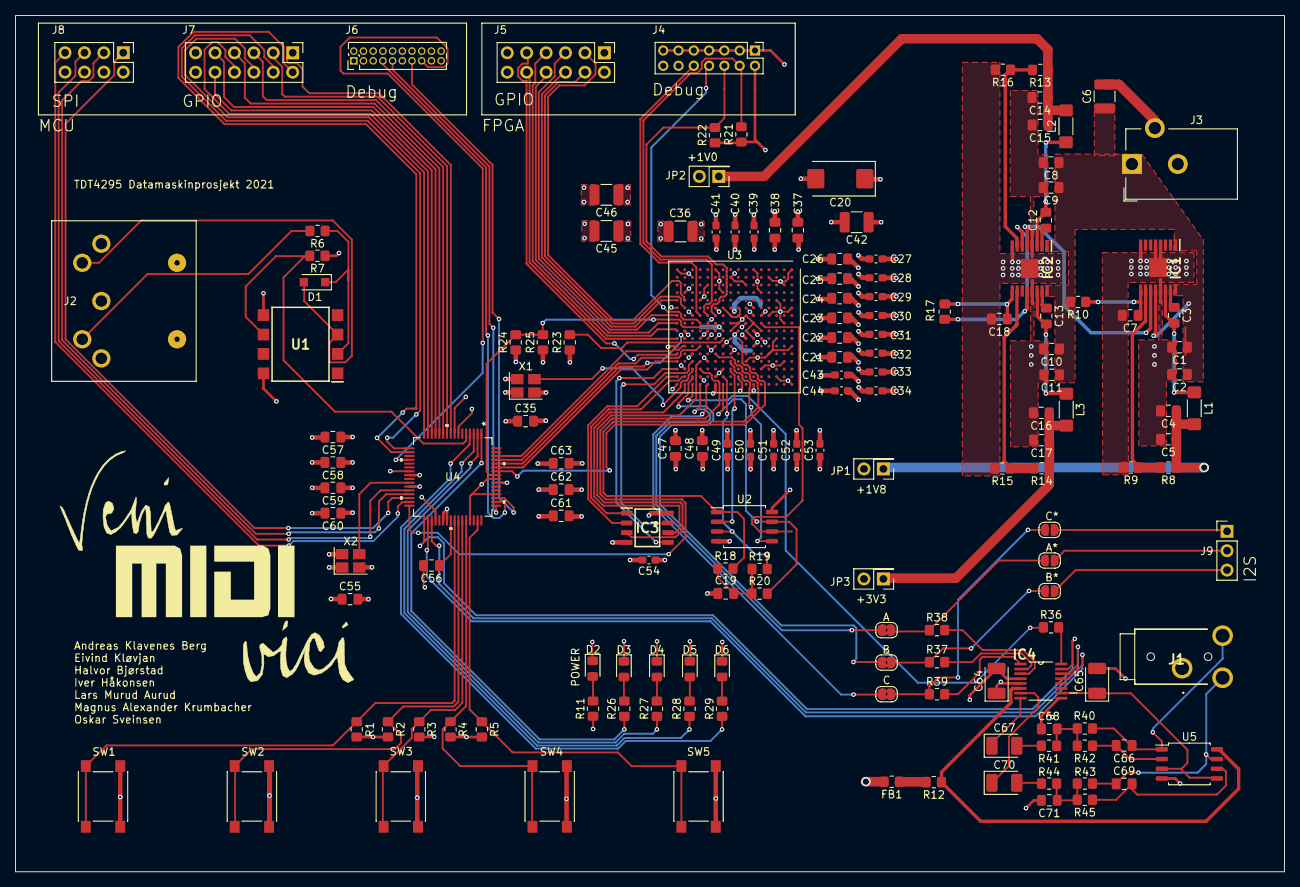
[picture p8: board main.kicad_pcb from above]

Board: 4 copper layers, 166.0 x 112.0 mm, 156 parts (0 on the bottom side), 123 nets.

Other parts of the board:
logo: G***; logo
svg2mod: G***; logo
