DMPRO2021-Audio/pcb/(commit log)

2021-09-06 Add MIDI-IN connector
    [main.sch]
2021-09-06 Implement MIDI input circuit.
    [main.sch]
2021-09-07 Add debug interface
    [main.sch]
2021-09-07 Moved some stuff around
    [main.sch]
2021-09-08 Add EFM32GG component library
    [main.sch]
2021-09-08 Place separate parts in hierarchical sheets, connect in main schematic
    [FPGA.sch, MCU.sch, MIDI-IN.sch, main.sch]
2021-09-08 Some cleanup
    [FPGA.sch, MCU.sch, MIDI-IN.sch, main.sch]
2021-09-09 Add PCM1780DBQ footprint
    [main.sch]
2021-09-09 Add DAC to bill of materials
2021-09-09 Add hierarichal sheet for FPGA
    Not done yet
    [FPGA.sch, MCU.sch, MIDI-IN.sch, main.sch]
2021-09-13 Add rotary encoders
    [main.sch]
2021-09-13 Setup DAC.
    [Digital-Analog-Out.sch, FPGA.sch, MCU.sch, MIDI-IN.sch, main.sch]
2021-09-13 Used wrong MIDI connector
    [MIDI-IN.sch]
2021-09-13 Add DAC footprint
    [Digital-Analog-Out.sch, MIDI-IN.sch]
2021-09-14 Move EFM32GG debug port inside MCU sheet
    [Digital-Analog-Out.sch, FPGA.sch, MCU.sch, main.sch]
2021-09-14 Simplify the top sheet, put bus connection inside the sheets
    [Digital-Analog-Out.sch, FPGA.sch, MCU.sch, main.sch]
2021-09-15 Setup FPGA power connections, connect FPGA flash
    [DAC.sch, Digital-Analog-Out.sch, FPGA.sch, MCU.sch, MIDI-IN.sch, main.sch]
2021-09-15 Finish (?) setting up FPGA as in the slides
    [FPGA.sch, MCU.sch, main.sch]
2021-09-15 Add FPGA oscillator, cleanup
    [FPGA.sch, MCU.sch]
2021-09-16 Add the MCU we will be using, try setting up power connections
    [MCU.sch, main.sch]
2021-09-16 Some small changes
    [MCU.sch]
2021-09-16 Add basic amplifier circuit
    Haven't yet added values for capacitors or resistors.
    Calculations seem quite straight forward though.
    [AMP_Analog_out.sch, DAC.sch, Digital-Analog-Out.sch, FPGA.sch, MCU.sch, MIDI-IN.sch, main.sch]
2021-09-17 Update BoM
2021-09-17 Remove old DAC files. Connect amplifier to audio out
    [AMP_Analog_out.sch, DAC.sch, FPGA.sch, MCU.sch, MIDI-IN.sch, main.sch]
2021-09-17 Add some component values to AMP
    [AMP_Analog_out.sch]
2021-09-20 Set up switching regulator circuits.
    We only use half of the switching regulator that generates the 1V0
    voltage. I'm not sure if the half not being used is connected correctly.
    [AMP_Analog_out.sch, DAC.sch, FPGA.sch, MCU.sch, MIDI-IN.sch, Power_supply.sch, main.sch]
2021-09-20 Remove old EFM32GG lib
    [DAC.sch]
2021-09-20 Continue wiring of the MCU
    [AMP_Analog_out.sch, DAC.sch, FPGA.sch, MCU.sch, Power_supply.sch, main.sch]
2021-09-21 Be consistent with capacitor values (always use F)
    [AMP_Analog_out.sch, DAC.sch, FPGA.sch, MCU.sch, Power_supply.sch, main.sch]
2021-09-21 FPGA connections, DAC linear regulator removed, DAC I2S breakout
    Connected the SPI, I2S and GPIO to some (mostly) arbitrary pins. Notably
    the SPI clock has to be connected to a clock pin on the FPGA.
    The linear regulator is (hopefully) not needed for the DAC as we already
    have a separate analog +3.3V created by the switching regulators.
    The I2S wires to the DAC are now connected to the FPGA as well as
    breakout pins over 0 ohm resistors, in case we need to connect to an
    external FPGA.
    [DAC.sch, FPGA.sch, Power_supply.sch]
2021-09-23 Some tweaks
    [AMP_Analog_out.sch, DAC.sch, FPGA.sch, MCU.sch, MIDI-IN.sch, Power_supply.sch, main.sch]
2021-09-23 Add FPGA RAM chip
    [AMP_Analog_out.sch, DAC.sch, FPGA.sch, MCU.sch, Power_supply.sch, main.sch]
2021-09-23 Final cleanup before sending in for rebiew
    [AMP_Analog_out.sch, DAC.sch, FPGA.sch, MCU.sch, MIDI-IN.sch, Power_supply.sch, main.sch]
2021-09-24 Fix up after review
    Done:
    - Add bulk decoupling capacitor to switch regulator cirucit
    - Disconnect DONE from PROGRAM_B in FPGA (mistake)
    - The decoupling capacitors used for the FPGA were for the 15T, not the
    100T. It was also setup for two I/O banks, we only use one. Disconnect
    I/O bank 15.
    - Switch external clock on the MCU to an oscillator, allowing for 72MHz
    - Switch pinout of the backup SPI on the MCU so that half the pins are
    ground
    Mizzing:
    - Add low-pass filters to the output of the DAC as per the datasheet.
    May remove the need for the amplifier circuit.
    [AMP_Analog_out.sch, DAC.sch, FPGA.sch, MCU.sch, MIDI-IN.sch, Power_supply.sch, main.sch]
2021-09-24 Fix up after review 2
    Don't route DAC_ZERO_{L,R} through FPGA into SHUTDOWN on the amp, it is
    not really necessary and just adds routing complexity.
    [AMP_Analog_out.sch, DAC.sch, FPGA.sch, main.sch]
2021-09-24 Fix up after review 3
    Add +3.3V and GND to MCU and FPGA GPIO.
    Add a lot of footprints.
    [AMP_Analog_out.sch, FPGA.sch, MCU.sch, Power_supply.sch, main.sch]
2021-09-27 DAC: Remove amplifier, replace with low pass as per datasheet
    Also: a lot of footprint association
    [AMP_Analog_out.sch, DAC.sch, FPGA.sch, MCU.sch, MIDI-IN.sch, Power_supply.sch, main.sch]
2021-09-27 Start PCB layout
    [DAC.sch, FPGA.sch, MCU.sch, MIDI-IN.sch, Power_supply.sch, main.kicad_pcb, main.sch]
2021-09-27 Continue PCB layout
    [FPGA.sch, MCU.sch, Power_supply.sch, main.kicad_pcb]
2021-09-28 Some more routing
    [Power_supply.sch, main.kicad_pcb]
2021-09-28 PCB getting close to being fully connected
    Still missing the power circuit, will look at it tomorrow.
    [FPGA.sch, main.kicad_pcb]
2021-09-29 Almost finished with PCB layout
    - Fixed FPGA power layout. The 1V0, 1V8 and 3V3 pins have to be
    connected to vias which in turn connect to fat lanes
    - Added logo and names
    - Started power circuit, this needs some work
    [Power_supply.sch, main.kicad_pcb]
2021-09-30 Finished (?) board
    [main.kicad_pcb]
2021-09-30 Fixes after review
    - +1V0 and +1V8 power zones on the backside of the FPGA
    - Vias directly next to decoupling capacitors
    [main.kicad_pcb]
2021-09-30 Fix MCU silk
    [main.kicad_pcb]
2021-11-18 Link to correct BOM
2021-11-18 Add missing junction
    [FPGA.sch]
2021-11-18 Add missing resistor to power supply
    [Power_supply.sch]
